uwo-fast/gb3dpe-pellet-system/(commit log)

2026-08-19 feat(cad): import pellet hopper design as received
    Parametric bulk hopper (body, roof mount, cap) with a four-tab bayonet
    coupling and three capacity presets, authored by our co-op student with
    ChatGPT assistance and emailed over as a loose folder.
    Imported verbatim so later changes diff against the original. Line
    endings normalised to LF per .gitattributes; no other edits. Renders
    clean in OpenSCAD across all three parts and all three sizes.
    Review of the design is tracked in TODO.md.
    [hopper_body.scad, hopper_mount.scad, hopper_sizes.scad, pellet_hopper.scad]
2026-08-19 docs: scaffold project docs, build gate, and open-work bank
    Fill in the org template for this project and give the CAD a CI-equivalent
    gate. `just check` compiles all three parts at all three capacity presets
    with OpenSCAD warnings treated as errors; the imported design passes.
    Add the extruder hardware reference, rescued from untracked local notes and
    extended with bounding boxes measured off the vendor CAD. Two of those
    measurements matter: the stock hopper holds only 20-30 g, which is the
    reason this project exists, and it carries no M4 bolt pattern, so the one
    in the imported mount was invented rather than inherited.
    Record the design review and open questions rather than acting on the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
2026-08-19 style(cad): apply formatter to imported hopper sources
    Normalises indentation to the two spaces .editorconfig asks for, spaces
    operators, adds trailing commas, drops doubled blank lines, and fixes the
    missing newline at end of hopper_sizes.scad.
    No geometry change: triangle count, mesh volume and bounding box are
    identical across all three parts at all three capacity presets. Compared
    by invariant rather than by file hash, because OpenSCAD does not emit
    STL facets in a stable order.
    [hopper_body.scad, hopper_mount.scad, hopper_sizes.scad, pellet_hopper.scad]
2026-08-19 test(cad): add geometry baseline and harden the render gate
    Adds scripts/geom_stats.py and a committed baseline so a refactor can be
    shown to be geometry-neutral rather than asserted to be. OpenSCAD does not
    emit STL facets in a stable order, so meshes are compared by signed volume,
    bounding box and triangle count, which are order-independent. Verified the
    harness both passes on an unchanged tree and fails on a deliberate 0.2 mm
    wall perturbation.
    Also stop trusting the render exit code on its own. Checked against
    OpenSCAD 2021.01: STL export does exit non-zero on a failing assert, and
    --hardwarnings promotes a WARNING to non-zero, but a reversed range
    [begin:end] with begin > end only repo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
2026-08-19 docs: record that the funnel wall is thinner than specified
    The wall parameter is applied as a horizontal offset, so on the sloped
    funnel the true perpendicular thickness is wall * sin(theta): 2.02 mm on
    the 2.5 kg preset down to 1.61 mm on the 10 kg one, against a nominal 3 mm.
    The shell is thinnest exactly where the pellet column bears on it.
    Steepening the funnel to the pellet-flow target fixes this as a side
    effect, which strengthens the case for making wall angle the primary input.
2026-08-19 refactor(cad): make hopper sizes a registry with accessor functions
    Replaces the bare HOPPERS table and positional P[1]..P[4] indexing with
    named rows, a hopper_size_registry bundle, and accessor functions.
    Accessors are the point: variables do not cross a `use <>` boundary but
    functions do, so this is what lets the part modules read a preset once they
    stop sharing globals with the driver. hopper_preset() asserts on a bad
    index rather than returning undef, which would otherwise propagate through
    every downstream dimension and render a silently wrong part.
    Verified the registry variable does not leak across `use <>` while the
    accessors do, and that the bad-index assert aborts with exit 1. G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
    [hopper_sizes.scad, pellet_hopper.scad]
2026-08-19 docs: measure funnel angle on the corner, not the faces
    The review reported face angles only. On a rectangular funnel the diagonal
    corner runs further out than either face over the same drop, so it is always
    the shallowest surface and is where pellets actually bridge. Measured on the
    corner the presets are 27-36 degrees, against 32-50 on the faces, and the
    10 kg corner at 27.1 is closer to a shelf than a chute.
    This changes the target for the funnel-angle work: the constraint belongs on
    the corner and the faces fall out steeper. Also records that a rectangular
    bin cannot hold equal X and Y wall angles for one drop, so a "wall angle"
    parameter has to say which surface it means.
2026-08-19 refactor(cad): give each part its own file and explicit parameters
    Replaces the shared-global layout with parameterised modules. Previously
    pellet_hopper.scad declared about fifty globals and then include'd the body
    and mount, which read those globals implicitly; neither could be opened,
    previewed or tested on its own, and the include order was load-bearing.
    Now every module takes what it needs as named arguments and each file
    renders standalone. A module that reads a caller's global across a `use <>`
    boundary is only a warning in OpenSCAD, exits 0, and silently coerces undef
    into geometry, so this class of coupling ships wrong parts rather than
    failing. The gate runs --hardwarnings for the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
    [hopper_body.scad, hopper_cap.scad, hopper_joint.scad, hopper_mount.scad, hopper_util.scad, pellet_hopper.scad]
2026-08-19 docs: bank the bayonet-lock-scad migration spec and the keying defect
    Records what the move to bayonet-lock-scad actually needs, from a review of
    the library source: the parameter mapping that reproduces today's joint,
    that its README has the mating convention inverted so the male half must be
    authored rotated by -sweep_angle, that the mount's annular seat has to stay
    or the pellet weight moves from a flat land onto four sphere contacts at
    roughly thirty times the contact stress, that the built-in detent is a
    0.6 mm post at our allowance and should be treated as absent, and the three
    asserts the library does not make that we have to.
    Separately, the fourfold symmetry of four evenly spaced t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
2026-08-19 feat(cad): drive the funnel from its wall angle and the feedstock
    Funnel angle was an emergent consequence of the footprint, the throat and a
    stored funnel height, which is how the imported presets ended up at 27 to 36
    degrees at the corner while being named for their capacity. It is now the
    input: set the angle, the drop is solved from it, and capacity falls out and
    is reported.
    The angle is measured on the diagonal corner. On a rectangular funnel the
    corner runs further out than either flat face over the same drop, so it is
    always the shallowest surface and the one that bridges; constraining a face
    instead leaves the corner well under target. The faces are echoed too, since
    they cannot bo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
    [hopper_body.scad, hopper_feedstock.scad, hopper_funnel.scad, hopper_sizes.scad, pellet_hopper.scad]
2026-08-19 docs: record design rationale and cite the numbers in use
    Several figures were being carried without a stated source: the 60/70 degree
    feedstock minimums, the 0.62 and 0.35 kg/L bulk densities, the 0.8 mm inner
    radius limit and the build envelope. Adds docs/design-notes.md with the
    reasoning and citations, and points at it from the files that use the
    numbers.
    Also writes down the OpenSCAD behaviour this repo depends on, all of it
    established by compiling rather than from documentation, since several of
    those behaviours are the reason the code is shaped the way it is.
    States plainly that the feedstock angles are design targets rather than
    measurements and that the regrind density is an esti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
    [hopper_body.scad, hopper_feedstock.scad, hopper_funnel.scad, pellet_hopper.scad]
2026-08-19 feat(cad): build the bayonet on bayonet-lock-scad, keyed
    Replaces the hand-rolled four-tab coupling with our own library, pinned by
    commit 85c43ae since it carries no tags. hopper_joint.scad was already the
    only file defining coupling geometry, so it is the whole of the change.
    The pattern is now keyed. Four evenly spaced tabs gave the joint four
    identical locked positions and the bin is rectangular, so half of them
    mounted it crosswise on the roof with nothing resisting.
    Two things the library gets wrong or leaves out, both settled by rendering
    rather than by reading it:
    Its README says a common origin gives the locked position. It does not: a
    common origin is the entry position, and for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
    [hopper_body.scad, hopper_cap.scad, hopper_joint.scad, hopper_mount.scad, hopper_util.scad, pellet_hopper.scad]
2026-08-19 docs: rescue the operating procedures out of untracked scratch
    The first-flash checklist and the PINDA jog-test protocol existed only in
    working.tmp on one machine, caught by *.tmp in the firmware repo's
    .gitignore. Both are now under docs/operations/.
    Their numbers were stale enough that importing them verbatim would have been
    worse than leaving them: the checklist still carried probe offsets of
    X -32 / Y -39, 4000 steps/mm and thermistor table 11, all from the iteration
    that the EEPROM discovery later invalidated. Corrected to the landed config,
    and both now say plainly which steps remain outstanding rather than reading
    as though the printer is fully calibrated.
    Worth noting for PR #1 in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
2026-08-19 feat(cad): retain the coupling with a radial screw
    Nothing resisted the bayonet backing off under a hose pull or a knock, with
    up to 10 kg of pellets hanging on it. The library does have a detent, but it
    is undocumented and its size is welded to allowance, so at our 0.30 it is a
    0.6 mm post -- at or below one extrusion width. Treated as absent.
    A self-tapping M4 now runs radially through the socket wall into a shallow
    pocket in the neck. That is a positive lock rather than a friction one: the
    tip seats in the pocket and has to be driven out, not merely slipped.
    Placement is the fiddly part and is asserted rather than trusted. The screw
    must clear the entry slots, which run from the channel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
    [hopper_body.scad, hopper_joint.scad, hopper_mount.scad, pellet_hopper.scad]
2026-08-19 feat(cad): drive the outlet from the feedstock, and resize the coupling
    Physical behaviour moves into functions. hopper_flow.scad carries the
    arching rules and hopper_feedstock.scad the per-material ratios, so the same
    rule reads in both directions: a requirement sizes the geometry, and the
    geometry reports what it can pass. Every render now echoes the largest
    particle the whole path will actually handle, which is the narrowest section
    rather than the one you had in mind.
    Two different rules were being conflated before, including by me in review. A
    CONVERGING outlet is where material funnels inward and arches form, and wants
    6x particle for round pellets or 10x for interlocking flake. A PAR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
    [hopper_feedstock.scad, hopper_flow.scad, hopper_joint.scad, pellet_hopper.scad]
2026-08-19 feat(cad): split the body into bolted segments
    A funnel steep enough for flake is taller than the printer, so nothing was
    buildable. The body now cuts into segments that bolt back together, and at
    202 x 202 in two segments no part exceeds the MK3S envelope: 209 x 209 x 205
    against 250 x 210 x 210. require_printable is on by default, so that is
    enforced rather than reported.
    Bin height stops being a stored preset field and becomes the remainder --
    the segments give a total height, the funnel takes what its angle demands,
    storage gets the rest. Capacity is an output of the flow requirement rather
    than an input competing with it, which is the whole reason the imported
    design ended up at 27 deg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
    [hopper_body.scad, hopper_funnel.scad, hopper_sizes.scad, hopper_split.scad, pellet_hopper.scad]
2026-08-19 docs: track colour assignment and three items the resize moved
    Adds the colour item: nothing calls color() today, and the assembly views
    should read one colour per printed part, never per feature within a part.
    Notes that the body is segmented now, so each segment is its own part.
    Also brings three existing items up to date with the coupling resize. The
    roof bolt pattern was already invented rather than inherited and has now
    been moved twice by the flange growing. The outlet-to-spigot step widened
    from 38 to 50 against an unchanged 20.6 mm spigot, which is what caps the
    reported spec at exactly 5 mm. And the vendor STEP files are still only in
    untracked scratch while being exactly what the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
2026-08-19 feat(cad): colour one per printed part, and add examples
    Colours are handed out bottom-up through the stack -- mount, each body
    segment, then the cap -- so parts that touch never share one, which is the
    only place it matters. They repeat beyond that, which is fine.
    The constraint that a part is exactly one colour is held by construction
    rather than by discipline: no part module contains a color() call at all.
    Parts are coloured only where the driver assembles them, so shading a flange
    differently from the shell it belongs to is not something a later edit can
    do by accident. That matters because none of these are multi-material
    prints and a two-tone part would say otherwise.
    Single-part ren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
    [bayonet_joint.scad, feedstock_comparison.scad, hopper_body.scad, hopper_colours.scad, pellet_hopper.scad, regrind_two_segment.scad]
2026-08-20 feat(cad): put the toolhead's own feed bore in the flow path
    The spec was reporting what our parts pass, not what the machine passes. The
    GreenBoy3D toolhead necks to a bore of its own where material drops onto the
    screw, and being machined metal it is the one opening we cannot size.
    Measured off the vendor STEP rather than assumed: 18.30 mm, centred exactly
    on the extruder axis, appearing identically in both sliding-pit parts. That
    is unambiguously the feed path rather than a fastener or a duct.
    It is also the binding section. The reported ceiling drops from 5 mm to
    4.575 mm for regrind, which is the honest figure -- our 50 mm outlet and
    20.6 mm spigot both clear 5 mm, and the machine sti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
    [hopper_flow.scad, pellet_hopper.scad]
2026-08-20 docs: record the real hose dimensions and the spigot bug they expose
    Bench-reported, deliberately not yet committed to the geometry: the
    conveyor tube is ID 20 / OD 21, 25 over a 2 mm helix at 8 mm pitch. That is
    a standard DN20 spiral-reinforced suction hose, and the helix standing proud
    is what lets it screw into a socket rather than push onto a spigot.
    pipe_id was assumed 25, and spigot_od was derived from it, so feeding the
    real number in fails the mount's own assert. Both spigot dimensions are
    wrong. Notes why shrinking them is the wrong fix: a push-in spigot would
    neck to 15.6 mm and become the tightest section in the path, tighter than
    the vendor's own feed bore, where a thread-in so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
2026-08-20 docs: split the mount into a feed head and a swappable adapter
    The hopper has to work on a bare MK3S and on the Original Prusa Enclosure,
    which means drilling its top sheet. One mount cannot do both, and
    hopper_mount() currently does five jobs in one part.
    Splitting it puts the bayonet socket, gussets, feedthrough and hose socket
    in an invariant feed head, and everything installation-specific in a small
    adapter that bolts to it on a pattern we define. Switching between
    installations becomes a cheap reprint of the adapter rather than the whole
    mount.
    That also settles the roof bolt-pattern item, which has been an invented
    number moved twice: the feed-head-to-adapter pattern is ours to defin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
2026-08-20 docs: define the three interfaces and make the mount a bulkhead
    The hopper needs to work on a bare MK3S, an enclosed one, and machines we
    have not seen, so it becomes modules joined at defined interfaces rather
    than a fixed set of parts.
    Records why the obvious layout does not work. A bayonet socket accepts from
    one end only, so a plate carrying the hopper above and the outlet below
    always has one connection facing the bed, and flipping it just swaps which.
    Quick-release can exist on one face of a plate, not both. That is the same
    reason the imported mount printed badly in every orientation.
    So nothing connects to the plate. The hub passes through it and a collar
    clamps it from underneath,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
2026-08-20 docs(interfaces): bolt the hub down and reuse one coupling
    Two corrections from working the numbers. The plate's clearance hole has to
    pass the outlet neck's pins at 64.3, not the 58 neck, which moves it from 59
    to 65.3. And the collar is unnecessary: bolting the hub to the plate and
    letting the outlet bayonet to the hub independently gives quick-release
    where it is wanted, keeps the hopper retained when the outlet is off, and
    stops the hub rotating when the body is twisted in -- three problems that
    the clamp-between-halves version each needed a separate answer for.
    Also settles interface B as the same coupling as A rather than a smaller
    one. The hose is 20 mm so the path must converge from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
2026-08-20 feat(cad): add the hub, and gate every module standalone
    The hub is the part that lets the plate stay flat. A bayonet socket accepts
    from one end only, so a plate carrying the hopper above and the outlet below
    always has one connection facing the bed and cannot be printed either way
    up. Putting both sockets on a short tube leaves the plate as a flat piece of
    material with holes in it.
    It bolts down rather than being clamped by the outlet, so the hopper stays
    retained when the outlet is twisted off to clear a jam, and the hub cannot
    turn when the body is twisted into it.
    Three things this took to get right, none of which were obvious:
    The lower socket is rotated 180 about X, not mirrored.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
    [hopper_hub.scad]
2026-08-20 feat(cad): add the plate, the hose registry and the outlet
    Completes the module stack. The plate is deliberately the dumbest part in
    the repo -- flat, holes only, no features on either face -- because it is the
    only machine-specific one, and the measurements we are least sure of should
    land on the part that costs least to remake. It can equally be laser-cut or
    made from acrylic or plywood.
    The outlet is where the path converges. The hub runs a straight 50 mm bore
    and the hose is 20 mm, so the neck-down has to happen somewhere, and a
    converging section is where material arches; putting it in the part that
    twists off in seconds means the place most likely to block is the place
    easiest to clea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
    [hopper_hose.scad, hopper_hub.scad, hopper_joint.scad, hopper_outlet.scad, hopper_plate.scad]
2026-08-20 refactor(cad): retire hopper_mount for the hub/plate/outlet stack
    The old mount did five jobs in one part and could not be printed cleanly in
    any orientation. It is replaced by the hub, plate and outlet, and the driver
    now drives those: render_part gains hub, plate and outlet, the assembly
    stacks them about the plate's top face, and every mount-era parameter --
    spigot, roof locator, flange, gussets -- is gone.
    Two things nearly went missing in the cleanup, both caught rather than
    noticed later:
    The retaining screw lived only in hopper_mount, so deleting it would have
    quietly dropped the coupling's only anti-rotation feature. It moves to the
    hub, now on both sockets, since the hose pulls on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
    [bayonet_joint.scad, hopper_colours.scad, hopper_hub.scad, hopper_joint.scad, hopper_mount.scad, hopper_outlet.scad, pellet_hopper.scad]
2026-08-20 feat(cad): add the MK3S frame plate
    The first machine-specific plate. It adds a saddle to the universal plate
    and inherits everything the hopper bolts to.
    It clamps rather than hooks, and that was the finding rather than the
    assumption. Prusa's own spool holder hangs on this frame and is the obvious
    reference, so it was worth checking how it engages: scanning its mesh for
    opposed parallel faces four to nine millimetres apart finds none anywhere,
    which means it has no frame slot at all. It is a cantilever hook that stays
    seated because the spool's weight holds it down -- fine for a kilogram of
    filament, wrong for three kilograms of pellets. So this straddles the frame
    and pinches it.
    The ho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
    [hopper_plate_mk3s.scad, mk3s_frame_mount.scad, pellet_hopper.scad]
2026-08-20 feat(cad): add a flow test coupon
    The whole design rests on the funnel wall angle, and those angles are design
    targets from general practice rather than measurements. The critical
    mass-flow angle depends on the wall friction of the surface material slides
    on, which for a printed part is nothing like the steel those figures assume,
    and the shredder's output varies on top of that.
    This is the cheapest way to find out: the real angle, throat, wall inset and
    corner radii, printed in the real material on the real machine, so the
    surface it presents is the surface the hopper will. Roughly 150 g of regrind
    and a couple of hours on the bed, against two twenty-hour segments. Legs and
    a base ring so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
    [flow_coupon.scad]
2026-08-20 docs: calculate the load cases
    Three things had been carrying loads with no analysis behind them, flagged
    repeatedly and never done. Now hand-calculated and re-runnable as geometry
    moves.
    The bin wall governs, at 4.49 MPa for a safety factor of 6.7. Everything
    else is an order of magnitude clear. Stresses are compared against 30 MPa
    rather than PETG's ~50 MPa bulk yield, because these are printed parts loaded
    across layers -- and that 30 is an assumption, not a measurement.
    The split joint turned out to be the case most likely to be reasoned about
    wrongly. The segments stack, so the flange bears in compression and the bolts
    resist prying; treating it as six bolts hanging 2.4 kg would give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
2026-08-20 feat(cad): add the panel plate, and correct a stale dimension
    The panel plate bolts through a drilled flat sheet -- the enclosure's top
    panel, or anything similar. It is the universal plate plus a mounting
    pattern, because that is all a flat panel needs: the panel carries the load
    in bending and the plate spreads it. The pattern is parametric rather than
    fixed, since where the holes can go depends on what is behind the panel and
    that has not been measured.
    It reports the diameter the panel itself has to be drilled to, and says
    plainly to use washers or a backing plate: four M4 heads pulling on thin
    sheet under a sustained few kilograms will dimple it long before anything
    breaks.
    Adding it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
    [hopper_plate_panel.scad, pellet_hopper.scad]
2026-08-20 fix(cad): reconnect the MK3S saddle, and land the panel counterbore
    Both are the same mistake about the same convention: rounded_box sits on
    z = 0 and extends UPWARD, so a plate built with it occupies 0..thickness and
    its underside is z = 0, not -thickness.
    The MK3S saddle was hung from -thickness, leaving it floating a plate's
    thickness clear of the part it is supposed to hold. It rendered without
    complaint and would have sliced into two objects. The panel's counterbore was
    placed below the plate entirely, so it cut nothing and the bolt heads would
    have stood proud.
    Neither was found by looking. They came out of measuring downward-facing flat
    area per part to work out print orientations -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
    [hopper_plate_mk3s.scad, hopper_plate_panel.scad]
2026-08-20 docs: add the printing and assembly guide
    Parts, quantities, hardware and the order things go together, so the design
    is buildable without reading the source.
    Print orientations are measured rather than guessed: downward-facing flat
    area above the bed, per part. Three parts want flipping and the reasons are
    specific -- segment 0 has a 12 mm horizontal ledge right round its split
    flange, the cap's entire cavity ceiling is unsupported as modelled, and the
    MK3S plate's underside is mostly clear of the saddle. Segment 1 has no
    unsupported area at all and the hub has 67 mm2, so both print as they sit.
    Leads with the flow coupon, because the wall angle is the assumption
    everything else rests on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
2026-08-20 docs: state the review's findings against the current tree
    The review is deliberately not rewritten as items are fixed -- it is the
    record of what arrived. But the one-line status note above it had gone stale,
    claiming findings 2 and 3 were open when the split and the hose and feed-bore
    measurements had landed. Replaced with a table so it stays checkable rather
    than being prose that quietly drifts.
2026-08-20 fix(cad): weld the outlet's cone to its neck, and gate on volume count
    The outlet was two disconnected pieces. Its cone ends exactly where the neck
    begins, and two solids meeting on a coincident plane are not reliably one
    volume -- it rendered clean, passed every assert and every dimensional check,
    and would have sliced as two objects. A collar straddling the junction fixes
    it.
    That is the third time this has bitten: the coupon's legs against its flange,
    the MK3S saddle against its plate, and now this. Every one of them looked
    right, measured right, and was wrong. So the gate now reads CGAL's volume
    count and fails any part that is not exactly one solid -- verified by
    removing the weld and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
    [hopper_outlet.scad]
2026-08-20 docs: specify the split joint seal
    Closed-cell foam tape on one flange face, inside the bolt circle, rather
    than a groove and an O-ring. What leaks here is flake dust, not liquid;
    printed flanges are never flat enough to seal hard face to face, and foam
    takes up that error where an O-ring would need the flatness it cannot get.
    It also costs no geometry, so changing it never means reprinting anything.
2026-08-20 feat(cad): register the bench measurements
    Four things measured on the machine and the material, replacing figures that
    were taken from documentation or from general practice.
    Regrind bulk density is 0.489 kg/L, not the 0.35 assumed -- 342 g settled to
    a beaker's 700 mL line, on shredded black Polymaker PolyLite PLA. That is 40%
    denser and it moves two numbers in opposite directions: capacity rises from
    3.03 to 4.24 kg, and the bin wall's safety factor falls from 6.7 to 4.8,
    because wall pressure scales with density. Still sound, but it is now the
    number to watch, and creep is what a safety factor does not cover. Recorded
    with provenance in docs/feedstock.md, since bulk density is a propert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
    [hopper_feedstock.scad, hopper_hose.scad, hopper_plate_mk3s.scad]
2026-08-20 fix(cad): stop the MK3S saddle overhanging the plate's clearance hole
    The saddle was hanging over the hole the outlet passes through. Adding the
    fillet made it obvious at 4.8 mm, but measuring it showed the saddle already
    overhung by 0.8 mm before the fillet existed -- the fillet exposed a bug
    rather than causing one.
    There are two minimum offsets and only the first was being enforced. The
    outlet hanging below the plate must clear the frame, which needs 38.6 mm. But
    the saddle -- jaws and fillet included -- is wider than the bar it grips and
    must also sit clear of the plate's own clearance hole, which needs 46.8. Both
    are asserted now and the message says which one bound.
    Moving the offset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
    [hopper_plate_mk3s.scad, mk3s_frame_mount.scad, pellet_hopper.scad]
2026-08-21 feat(cad): brace the MK3S plate, and derive its sizing
    The plate was too flexible. Not close to yield -- it deflects half a
    millimetre at the hub, but with 450 mm of hopper standing above that, half a
    millimetre becomes nearly five at the top, on a machine that slings its bed
    in Y. Stiffness sizes this part, not strength.
    So the saddle now spans the full plate width instead of a stub in the middle,
    which also stops its ends being a stress concentration and stops the mount
    tilting on the bar, and braces turn the flat cantilever into a T-section.
    Together worth roughly fifteen to twenty times the stiffness for a few grams.
    The saddle fillets into the plate as well, since that junction carries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
    [hopper_hub.scad, hopper_outlet.scad, hopper_plate_mk3s.scad, pellet_hopper.scad]
2026-08-21 refactor(cad): split the coupon's stand from its funnel
    Two reasons, both practical. The funnel alone is a plain tapered shell that
    prints inverted with nothing overhanging, where legs hanging off it forced
    compromises. And one stand is reusable across every angle worth comparing,
    which is the point of testing more than one.
    That only works if the flange is a FIXED outer size regardless of angle --
    deriving it from the funnel would give each angle its own flange and defeat
    the sharing. So the flange is 150 whatever the wall angle, and only its width
    changes: 25 mm at 70 degrees, 13 at 60. Asserted from both directions, that
    the funnel still passes the stand's opening and that the flange is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
    [flow_coupon.scad]
2026-08-21 refactor(cad): splay the stand's legs and drop its bottom ring
    The ring was not earning its place. In the print orientation the CARRYING
    ring is the one on the bed, so a second ring at the far end contributes
    nothing to adhesion -- its only job was stiffening the leg ends, and four
    legs on a 170 mm ring already tip at about 34 degrees under a coupon that
    weighs well under a kilogram.
    The legs are a little larger and splay outward toward their feet instead.
    That widens the base, stiffens them against splaying under load, and costs
    nothing to print: five millimetres over the leg height is three degrees off
    vertical, and the assert refuses anything past thirty.
    Worth noting for anyone reading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
    [flow_coupon.scad]
2026-08-25 test(cad): cover every printed part in the geometry baseline
    The baseline rendered five parts at three presets, but the hub, plate and
    outlet come out identical at every one -- so six of the fifteen renders
    proved nothing, while six real parts were never rendered at all: the upper
    body segment, the universal and panel plates, and the flow coupon and its
    stand. A refactor was free to change any of those unnoticed.
    Sweep only the body and the cap over the presets, and add a case for each
    part that was missing. Same fifteen renders, all fifteen now distinct, and
    3m14 rather than 4m47.
    Tolerance drops to zero on both volume and bounding box. A refactor that
    changes no geometry reproduces the m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
2026-08-25 refactor(build): judge every render in one place in the gate
    The check recipe carried four near-identical copies of the same block:
    run openscad, test the exit code, grep both streams for ERROR/WARNING/
    DEPRECATED, and for a printed part read CGAL's volume count. Adding a case
    meant copying it a fifth time.
    Collapse them onto one `run` helper taking the kind of render being judged
    -- solid, mesh or echo -- so each case is a single line, and use that to
    close the same coverage gaps the geometry baseline had: all three plate
    variants as the driver assembles them, the coupon at both angles, and the
    stand, which is not the coupon file's default part and so was never built.
    The size sweep drops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
2026-08-25 refactor(cad): inline the footprint presets, drop the size registry
    hopper_sizes.scad spent 52 lines, a registry, three accessors and a
    validating lookup on three square footprints that only the driver ever read.
    The rows carried a label as well, which was only ever echoed and is just the
    two numbers with an x between them.
    Inline the three pairs, derive the label, and delete the file. The customizer
    dropdown is unchanged.
    The index check moves into the assignment expression rather than becoming a
    top-level assert, because a top-level assert STATEMENT cannot guard the
    assignments above it: the scope's assignments are evaluated first, so
    hopper_size=7 got as far as funnel_corner_run() and r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
    [hopper_sizes.scad, pellet_hopper.scad]
2026-08-25 refactor(cad): collapse the funnel's two lerps into one
    funnel_span_at() and funnel_radius_at() were the same linear interpolation
    written twice, and funnel_body_section() -- their only caller -- worked around
    their signature by passing height=1 and z=t to make them interpolate on a
    ratio instead of a height.
    One _lerp(a, b, t) does both and reads as what it is at the call site. The
    note about why the section is linear moves onto funnel_body_section(), which
    is where it matters.
    [hopper_funnel.scad]
2026-08-25 refactor(cad): fold the split flange's position functions into one
    split_dowel_positions() and split_bolt_positions() each existed to slice a
    different part of split_fixing_positions()'s eight, and each had exactly one
    caller, which then ran two near-identical loops to drill them.
    One loop over the eight, picking the diameter by index. Which two are dowels
    is now stated where the eight positions are defined and their order is
    visible, rather than as p[0] and p[7] in a function three definitions away.
    [hopper_split.scad]
2026-08-25 refactor(cad): consolidate the CAD into eleven module files
    Three merges, each folding files that were one concern split across several.
    Taken as one change because they overlap in the driver's use<> block and no
    intermediate state is a working tree.
    hopper_plate_mk3s.scad and hopper_plate_panel.scad fold into
    hopper_plate.scad. There is one part here in three versions, not three parts:
    both variants were already `use <hopper_plate.scad>` plus a machine's own
    features, so the outline, clearance hole and hub fixings were shared by
    construction. Only the mk3s preview survives, because it is the one drift.py
    compares against the driver -- and since the gate now renders all three
    variants throu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
    [feedstock_comparison.scad, flow_coupon.scad, hopper_body.scad, hopper_feedstock.scad, hopper_flow.scad, hopper_hose.scad, hopper_outlet.scad, hopper_plate.scad]
2026-08-25 docs: the panel plate's pattern is parametric by design, not pending
    Four places described the panel bolt pattern as provisional pending a
    measurement of the enclosure, and TODO.md carried building the plate as open
    work blocked on that measurement.
    Neither is true: the plate is built, and the pattern is parametric because the
    panel is drilled to suit the installation. There is no fixed pattern to match
    and nothing to measure.
    [hopper_plate.scad, pellet_hopper.scad]
2026-08-25 refactor(cad): derive the funnel one direction only, from its angle
    hopper_body() took funnel_height and immediately recovered the angle from it
    by atan(), to get the wall inset -- while the driver had solved that height
    from exactly that angle by tan() two files earlier. An angle went to a height
    and back to an angle to answer a question the caller already knew.
    It now takes funnel_angle and solves the height itself, using the same
    funnel_height_for_angle() the driver uses. funnel_corner_angle() had no other
    caller and goes with it. Geometry is unchanged at 15/15, which also confirms
    the round trip was costing nothing but clarity.
    Three more places where the driver was re-deriving what an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
    [hopper_body.scad, hopper_funnel.scad, pellet_hopper.scad]
2026-08-25 refactor(cad): cut the examples from four to two
    bayonet_joint.scad rendered the neck beside the socket, which is exactly what
    hopper_joint.scad's own standalone preview already renders. The one thing it
    added was an echo of the four diameters that matter, so that moves onto the
    preview and the example goes.
    feedstock_comparison.scad and regrind_two_segment.scad were two halves of one
    story -- regrind needs a steeper wall, which makes its funnel taller, which is
    why the body has to be split at all -- and each rebuilt the driver's height
    derivation to tell its half. body_by_feedstock.scad tells both: each feedstock
    at its minimum angle, split into the segments that height demands, laid out a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
    [bayonet_joint.scad, body_by_feedstock.scad, feedstock_comparison.scad, hopper_joint.scad, regrind_two_segment.scad]
2026-08-25 docs: stop repeating the superseded 6.2 mm aluminium frame figure
    The frame was measured on this machine as 6.3 mm steel, and frame_thickness
    is set to 6.3 -- but three comments still stated 6.2 mm aluminium as fact,
    including one in the driver sitting ten lines above the measurement that
    contradicts it, and one in the MK3S example describing a stub the same file
    builds at 6.3.
    The remaining mentions of 6.2 are left alone: those cite it as what public
    sources claim, against what the caliper found.
    [mk3s_frame_mount.scad, pellet_hopper.scad]
2026-08-25 style(cad): reflow the multi-line assert messages
    Sixty asserts spanned 308 lines, most of them a str() broken across four to
    eight lines with the sentence split mid-phrase to fit -- "must be at least 0.8
    more " / "than the wall inset (" -- which is neither shorter nor easier to
    read than the sentence itself.
    Merge adjacent string literals and rewrap at 80 columns. Asserts already on
    one source line are untouched, and a message the author had already put on a
    single line stays there however wide, so this only compresses what was
    genuinely spread out.
    No message text changes. Verified rather than assumed: twenty of the asserts
    can be triggered from the command line, and the exact ERROR text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
    [flow_coupon.scad, hopper_body.scad, hopper_hub.scad, hopper_joint.scad, hopper_outlet.scad, hopper_plate.scad, pellet_hopper.scad]
2026-08-25 docs(cad): drop the comments that repeat another file verbatim
    Only restatement, per the agreed policy -- every comment carrying rationale
    that lives nowhere else is untouched.
    The three-line note on why standalone previews pass $fn on the call rather
    than assigning it appeared verbatim in three files and in full in
    design-notes.md; it becomes one line and a pointer. Two files carried the same
    two-line note about naming the facet count for drift.py.
    Four facts were stated in two or three places at once: that machine plates
    difference their pattern out of the universal one (the plate file's header and
    its own universal section and the driver), that the library's detent is too
    small to count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
    [flow_coupon.scad, hopper_body.scad, hopper_cap.scad, hopper_colours.scad, hopper_hub.scad, hopper_outlet.scad, hopper_plate.scad, hopper_util.scad]
2026-08-25 docs: record the simplification pass in the changelog
    Also corrects the repository layout list, which named the mounting plates as a
    separate item from the plate now that all three variants share one file.
2026-08-26 docs: rewrite TODO around what is actually still open
    The file had grown to 234 lines carrying 19 completed items alongside 24 open
    ones, so the open work was buried in a record of finished work that commits,
    CHANGELOG.md and the docs already hold. Completed items are gone; the file now
    holds open work only, and an item leaves it when it is done rather than being
    ticked and kept.
    Four items were open but already settled or obsolete:
    - "Revisit the step from outlet to spigot" and "Register the real conveyor tube
    dimensions and redesign the spigot" were both written against the retired
    hopper_mount.scad and its spigot_id/spigot_od asserts, which no longer exist.
    Both are done: the hose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
2026-08-26 refactor(cad): remove the coupling retaining screws
    The two radial M4s -- one per hub socket, each seating in a pocket in the
    mating neck -- are gone, along with the whole retainer apparatus: three spec
    fields, three asserts, four modules, three accessors and three driver
    parameters.
    They were treated as a symmetric pair, and that was the mistake. Disengaging a
    bayonet means rotating back through sweep_angle and THEN travelling entry_depth
    axially, and gravity sits on opposite sides of that travel at each end. At the
    upper socket the body must be lifted 12 mm against its own loaded 4.24 kg, so
    rotation alone releases nothing: that screw guarded a failure gravity already
    prevents. At the low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
    [hopper_body.scad, hopper_hub.scad, hopper_joint.scad, hopper_outlet.scad, pellet_hopper.scad]
2026-08-26 fix(cad): correct the conveyor hose profile to the measured rib
    The rib was recorded as 4 mm diameter at 8 mm pitch. Measured on the bench it
    is a semicircular section of 3.5 mm diameter wound at 7.6 mm pitch, so overall
    diameter across the ribs is 24.5 mm rather than 25. Bore and tube OD are
    unchanged at 20 and 21.
    This matters more than half a millimetre usually would, because the rib IS the
    thread: the outlet's socket is cut to match it, so a wrong pitch means the hose
    does not wind in at all. The outlet loses 1195.181 mm3, mostly from the socket
    OD following hose_outside() down half a millimetre.
    Handedness stays marked unconfirmed -- the next commit adds the coupon that
    settles it. Th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
    [hopper_specs.scad]
2026-08-26 feat(cad): add a hose thread test coupon to settle the socket by printing
    The outlet's hose socket is the least-tested feature in the build. Nothing in
    it has ever been printed: the clearance is a guess, the engagement length is a
    guess, and the handedness is marked NOT CONFIRMED. It is also now the only
    thing resisting the outlet backing off the hub.
    The coupon cuts its socket with hose_thread() from hopper_outlet.scad -- the
    production module, renamed from _hose_thread to say so, not a copy -- so a
    clearance settled here is a clearance the outlet will print, with nothing in
    between to get wrong. It models in the orientation it should be printed in,
    socket mouth at the bed, which is how th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
    [hopper_outlet.scad, hose_thread_coupon.scad]
2026-08-26 refactor(cad): cut the hose coupon down to the socket alone
    One cylinder, one bore, one helical groove. The hex grip, engraved labels,
    clearance sweep, asserts, echo and second recipe were all things I added that
    nobody asked for; they made a 17 MB STL out of a test ring.
    43 lines, one solid, 1.7 MB.
    [hose_thread_coupon.scad]
2026-08-26 fix(cad): sweep the hose thread properly instead of twisting an extrusion
    linear_extrude(twist=) collapses the section at this radius and pitch: the
    groove tool measured 283 mm3 against 2484 mm3 for the helical rod it is meant
    to be, so the coupon came out as a smooth bore with a scratch in it.
    The groove is now the rib section swept along its own helix as a single
    polyhedron -- 3063 mm3 against 3173 analytic, the gap being the 32-gon section.
    Hulled spheres along the path are also correct but CGAL never finishes them.
    Round thread, so the crest between turns is blunt. 6 s, one solid, and the
    groove removes 1112 mm3 where it should remove about 1150.
    [hose_thread_coupon.scad]
2026-08-26 fix(cad): the outlet hose thread was cutting 11% of its groove
    Same defect the coupon had, in the shipped part: hose_thread() swept the rib
    section with linear_extrude(twist=), which collapses it at this radius and
    pitch. Measured 292 mm3 against the 2557 mm3 of helical rod it should be. The
    socket was effectively a smooth bore with a scratch in it, and the hose would
    never have wound into it.
    It is now the same swept polyhedron the coupon uses -- a true round thread with
    a blunt crest. Outlet 45466.4 -> 44431.1 mm3; baseline rewritten.
    The sweep is written out in both files rather than shared, because the coupon
    is a standalone spike meant to be thrown away. Worth collapsing into one plac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
    [hopper_outlet.scad]
2026-08-26 refactor(cad): make the hub bolt circle an input, not a function of depth
    hub_bolt_circle(skirt_diameter, bolt_depth) derived where the fixings sit from
    how deep you wanted them, which is backwards: the bolt circle is the free
    choice, squeezed between the plate clearance hole and the skirt edge, and the
    depth is just what a 45 degree flare leaves you at that radius.
    So bolt_depth is gone. bolt_circle is the parameter, and hub_seat_z() reports
    what falls out of it.
    The fixings also stop being blind self-tapped holes. They now pass straight
    through the flange to a nut, counterbored from above so the nut seats on flat
    material rather than on the cone -- the floor has to clear the OUTER edge o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
    [hopper_hub.scad, hopper_plate.scad, pellet_hopper.scad]
2026-08-26 test(cad): rebaseline after the hub through-bolts and counterbores
    Only the hub moves: 62382.693 -> 61732.969 mm3. The four blind 4.2 mm holes
    became 4.5 mm through-holes with Ø8 counterbores over them, so the flange loses
    649.7 mm3 net.
    Everything else matches, which is the useful part: the change is contained to
    the part it was meant to change.
2026-08-26 docs: reconcile the docs with the design changes on this branch
    The branch stopped being a pure refactor partway through, and several places
    still described the old design.
    CHANGELOG advertised the retaining screw as a feature under Added; it was added
    and removed inside the same unreleased cycle, so it goes rather than appearing
    as both. Adds Fixed and Removed sections for the thread bug, the hose profile
    and the retainers, and a Changed entry for the hub through-bolts. The
    geometry-neutrality note is qualified: the simplification was neutral, the
    design changes after it deliberately were not.
    interfaces.md claimed a model of the hose screws into the outlet without
    interference. That chec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
2026-08-26 feat(cad): tune the hose bore and thread fits separately
    One clearance drove three things: the socket bore the tube slides in, the groove
    the rib winds into, and the socket OD. Those are two different fits on a moulded
    part with no published tolerance, and neither is calculable -- both come from
    printing a coupon and trying it -- so they should not have to move together.
    hopper_outlet() now takes bore_clearance and thread_clearance, and the driver
    exposes hose_bore_clearance and hose_thread_clearance to the Customizer, which
    it did not expose at all before: the outlet was quietly built at the module
    default whatever the driver said. The socket OD follows the thread clearance,
    since the rib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
    [hopper_outlet.scad, pellet_hopper.scad]
2026-08-26 docs: the CAD is designed and unprinted, not an imported first draft
    The README still opened "Status: early ... an imported first draft under active
    review ... do not print from it yet". The review is done and most of its
    findings are fixed, so that undersold the state; and "do not print" was wrong in
    the other direction, because the test coupons are the whole point and are meant
    to be printed.
    What is actually true: it compiles, asserts and is regression-tested, and it has
    never been printed, so the funnel angle, the hose fit and the mount under load
    are targets rather than measurements. Says that instead.
2026-08-26 style: run the formatters over the scad and the docs
    Reflow only -- every one of the 15 gate parts renders to the same volume
    and bounding box as the committed baseline, to zero tolerance.
    Two places needed a hand afterwards, where the formatter changed meaning
    rather than layout:
    The markdown formatter read the fill-in blanks in the probe-offset record
    as emphasis, so `______` came back as a bolded two-character `__`. Those
    are the fields the test is meant to be written into, so they are now
    inline code, which the formatter leaves alone.
    In _plate() a comment sat between `if (...)` and its body, which left the
    formatter with no body to indent: it pulled the mk3s call out to the same
    leve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
    [body_by_feedstock.scad, flow_coupon.scad, hopper_body.scad, hopper_cap.scad, hopper_funnel.scad, hopper_hub.scad, hopper_joint.scad, hopper_outlet.scad]
2026-08-27 fix(cad): run the hub's counterbore clear through instead of stopping short
    The counterbore ran `_skirt_h + 2` from the seat, which ends at z 17.5 --
    six millimetres above the skirt it was sized against, and in the middle of
    the upper socket's outer wall. That left an abrupt 0.5 mm ledge partway up
    the pocket the nut and driver have to pass. It now runs the hub's full
    height, so the pocket is the same section all the way out.
    Measured rather than assumed, since the counterbore does graze the socket:
    its inner edge is at r 35.5 against a socket outer wall at r 36. That takes
    0.5 mm off a 6.7 mm wall in four places, leaving 6.2 mm, and stops 3.35 mm
    short of the bayonet channel, whose outer e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
    [hopper_hub.scad]
2026-08-27 fix(cad): give the outlet the hose thread the coupon settled
    The coupon threads, so its figures are the real ones. Three of the four
    moved: the tube is 21.5 mm not 21, the pitch 8.5 mm not 7.6, and 0.2 mm of
    clearance is enough on both the bore and the groove where 0.4 was assumed.
    The rib is 3.5 mm and right-handed as recorded.
    The coupon also carried a lead-in the outlet did not. A swept polyhedron
    begins on a flat cap, and the outlet swept from 0.5 mm below the socket
    mouth, which puts that cap inside the part: solid material across 57 degrees
    of the entry, where the rib meets a wall instead of a groove. Measured on a
    0.4 mm slice at the mouth face, holding every dimension equal and vary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
    [hopper_outlet.scad, hopper_specs.scad, hose_thread_coupon.scad, pellet_hopper.scad]
2026-08-30 fix(cad): colour each body segment in the assembly preview
    Each segment is built as the whole body clipped to its own slab, so
    every segment's tree still carries a full-height funnel that the clip
    is meant to remove. Preview resolves CSG by depth peeling, and a
    hollow lofted body inside an intersection is deeper than the default
    single layer, so the upper segment's discarded funnel drew straight
    over the lower one and the body came out one colour.
    Wrapping each segment in render() forces exact CSG for that view. It
    costs the assembly preview roughly 0.9 s to 22 s; single-part previews
    are untouched at 0.17 s, and exported meshes were never affected.
    Reordering the intersection's children w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
    [pellet_hopper.scad]
2026-08-30 feat(cad): give each body segment its own render_part entry
    A segment is a separate print, so it is a separate part. render_part
    now carries body0..body3 and the separate `segment` selector is gone;
    _BODY_PARTS is index-matched, so a name and the segment it renders
    cannot disagree.
    Every segment the model can build is listed, not just the ones the
    current `segments` makes. A Customizer annotation is literal text
    parsed before evaluation: it cannot be computed, and it does not
    validate either -- a parameter set feeds a value straight through one.
    A shorter list would only hide parts and force a source edit to reach
    them. Picking one the current count does not build now names the knob
    and the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
    [pellet_hopper.scad]
2026-08-30 fix(cad): lift the mk3s mount so the outlet clears the frame bar
    The outlet hangs below the plate and beside the frame, in the column
    the gantry rises through, so at full Z the toolhead reached it. It sat
    53.2 mm below the frame's top edge at 47 mm off the frame plane.
    The saddle's roof already was the material between the frame's top edge
    and the plate underside, so it is also the height the mount stands off
    the frame -- it was just fixed at 6 mm and never exposed. It is now
    solved rather than chosen: the roof is whatever puts the outlet's mouth
    `frame_outlet_clearance` above the top bar. That needs nothing measured
    on the machine, since nothing that travels can rise above that bar, and
    it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
    [hopper_plate.scad, mk3s_frame_mount.scad, pellet_hopper.scad]
2026-08-31 fix(cad): run the mk3s braces under the hub and stop them at the bar
    Both brace defaults now follow the mount they are bracing instead of
    being tied to the saddle:
    _reach = offset + skirt_diameter / 2 - _saddle_w / 2 36.7 -> 84.2
    _brace_h = saddle_roof 92.2 -> 62.2
    The height was tied to the saddle's, the reach was not, so making the
    roof a riser grew each brace downward and not outward -- a 44 degree
    wedge became a 68 degree fin. Two faults followed.
    It hung below the bar. Intersecting the plate with the region inboard
    of the saddle's inner face and below the frame's top edge returned
    6.49 cm3 of brace reaching 30 mm under the bar, in the column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
    [hopper_plate.scad]
2026-08-31 fix(plate): correct plate bolt z loc to correctly perform clean thru bore
    [hopper_plate.scad]
