uwo-fast/gb3dpe-pellet-system/(notices)

Notices in the files:
README.md:
License: GPL-3.0
